roycohen2013/Makerslide/README.md

Most of the code and designes for this device are not in fact mine and are from another developer whos name is mentioned in the code. I merely edited and improved some aspects of the code and hardware to suit my needs better.
