roycohen2013/Makerslide/Makerslide camera slider parts.rtf

1 X MakerSlide 1800mm

4 X Dual Bearing V wheel kits

6ft X Neoprene Belt

2 X Smooth idler wheel kits

14 X precision shim washers

10 X nylon natural spacers

2 X eccentric spacers

15 X 5mm X 0.8mm socket cap screw

15 X 5mm X 0.8mm nylon locking nut

8 X T-slot Nut

1 X Motor/bearing wheel carriage plate

1 X NEMA 17 stepper motor

1X Stepper motor controller
