roycohen2013/Makerslide/Makerslide Designs/Belt clip bottom.sldprt

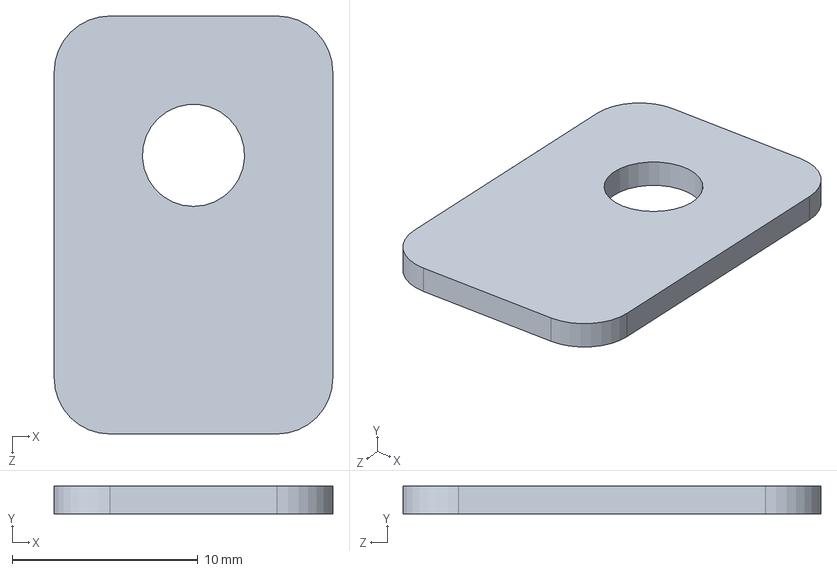
[picture p1: CAD file, 2013-01-02]
Makerslide Designs/Belt clip bottom.sldprt
15.0 x 1.50 x 22.5 mm
