roycohen2013/Makerslide/Makerslide Designs/Sub plate.sldprt

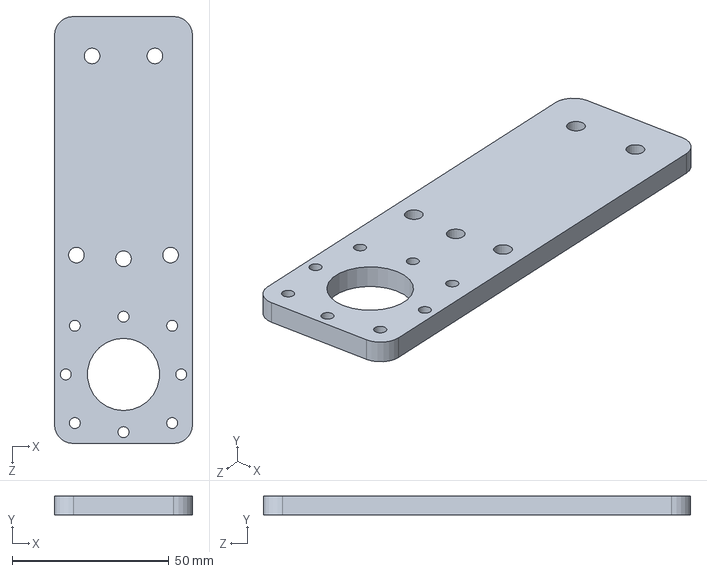
[picture p2: CAD file, 2013-01-02]
Makerslide Designs/Sub plate.sldprt
44.0 x 6.00 x 136.0 mm
