roycohen2013/Makerslide/Makerslide Designs/Rail Clip.sldprt

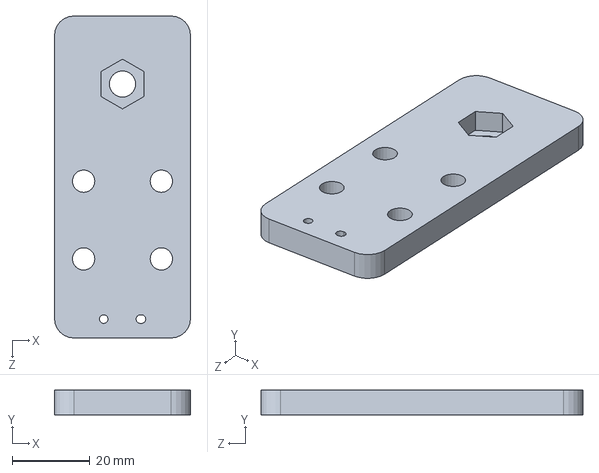
[picture p3: CAD file, 2013-01-02]
Makerslide Designs/Rail Clip.sldprt
35.0 x 6.35 x 82.8 mm
