roycohen2013/Makerslide/(list of files, cad)

Other CAD files:
Makerslide Designs/HN2520MS.sldprt
Makerslide Designs/BHCSM530S.sldprt
Makerslide Designs/SPACER_192_375_312.sldprt
Makerslide Designs/SPACER_192_375_312_1.sldprt
Makerslide Designs/CS_PLATE_1.sldprt
Makerslide Designs/SPACER_192_312_125.sldprt
Makerslide Designs/PHMSM310S.sldprt
Makerslide Designs/HNKK55.sldprt
Makerslide Designs/BEARING_5_16_5.sldprt
Makerslide Designs/BHCSM520S.sldprt
Makerslide Designs/SPACER_192_312_125_1.sldprt
Makerslide Designs/SPACER_192_375_250_1.sldprt
Makerslide Designs/SPACER_192_375_250.sldprt
Makerslide Designs/CS_BELT.sldprt
Makerslide Designs/B10-10001_1.sldprt
Makerslide Designs/FLW10SS.sldprt
Makerslide Designs/B10-10001.sldprt
Makerslide Designs/SHMSM510S.sldprt
Makerslide Designs/BHCSM530S_1.sldprt
Makerslide Designs/HNM5NL_1.sldprt
Makerslide Designs/A_6T16M020DF6005.sldprt
Makerslide Designs/PHMSM310S_1.sldprt
Makerslide Designs/Belt clip top.sldprt
Makerslide Designs/HNM5NL.sldprt
Makerslide Designs/SHMSM512S.sldprt
Makerslide Designs/BEARING_5_16_5_1.sldprt
Makerslide Designs/CS_PLATE.sldprt
Makerslide Designs/Belt clip.sldprt
Makerslide Designs/30048_ASM.sldasm
Makerslide Designs/B17021.sldprt
Makerslide Designs/B17021_1.sldprt
Makerslide Designs/B17022_350.sldprt
Makerslide Designs/B17023.sldprt
Makerslide Designs/B17023_1.sldprt
Makerslide Designs/B17036.STL
Makerslide Designs/B17036.sldprt
Makerslide Designs/B17046.sldprt
Makerslide Designs/B17047.sldprt
Makerslide Designs/B17048.sldprt
Makerslide Designs/B18001-001.sldprt
Makerslide Designs/B18001-001_1.sldprt
Makerslide Designs/B18026.sldprt
Makerslide Designs/B18026_1.sldprt
Makerslide Designs/B30037_ASM.sldasm
Makerslide Designs/B30041_ASM.sldasm
Makerslide Designs/C17045.sldprt
Makerslide Designs/C17045_1.sldprt
Makerslide Designs/C30047_ASM.sldasm
Makerslide Designs/Exports/Belt clip bottom.DXF
Makerslide Designs/Exports/Belt clip top.DXF
Makerslide Designs/Exports/Rail Clip.DXF
Makerslide Designs/Exports/Sub plate.DXF
Makerslide Designs/c30049_rev_1.SLDASM
