roycohen2013/Makerslide/ms ms_slider   Buildlog.net Wiki.html

Buildlog.net Wiki (http://www.buildlog.net/wiki/doku.php)

−Table of Contents

MakerSlide - Simple Camera Slider (http://www.buildlog.net/wiki/doku.php?id=ms:ms_slider&s[]=camera&s[]=slider)

Introduction (http://www.buildlog.net/wiki/doku.php?id=ms:ms_slider&s[]=camera&s[]=slider#introduction)

Part Drawings

Carriage Assembly (http://www.buildlog.net/wiki/doku.php?id=ms:ms_slider&s[]=camera&s[]=slider#carriage_assembly)

Slider Assembly (http://www.buildlog.net/wiki/doku.php?id=ms:ms_slider&s[]=camera&s[]=slider#slider_assembly)

Camera Mounting (http://www.buildlog.net/wiki/doku.php?id=ms:ms_slider&s[]=camera&s[]=slider#camera_mounting)

Slider Setup (http://www.buildlog.net/wiki/doku.php?id=ms:ms_slider&s[]=camera&s[]=slider#slider_setup)

Tripod Mounting (http://www.buildlog.net/wiki/doku.php?id=ms:ms_slider&s[]=camera&s[]=slider#tripod_mounting)

Motor Control (http://www.buildlog.net/wiki/doku.php?id=ms:ms_slider&s[]=camera&s[]=slider#motor_control)

Photos (http://www.buildlog.net/wiki/doku.php?id=ms:ms_slider&s[]=camera&s[]=slider#photos)

MakerSlide - Simple Camera Slider

Introduction

This camera slider is more of a demonstration project than a polished design. The goal was to use as many off the shelf Makerslide parts as possible. The custom parts are the motor and idler pulley support plate, the tripod mounts and the belt clips. These parts are all open source and easy to fabricate. There are no tight tolerances on the parts and could be made with several techniques including hand fabrication.

The Adobe Flash Plugin (http://www.adobe.com/products/flashplayer/) is needed to display this content.

Part Drawings

C30047 Carriage Assembly Drawing - PDF (http://www.buildlog.net/cnc_laser/erp/get_doc.php?docNumber=C30047) - STEP (http://www.buildlog.net/cnc_laser/erp/get_doc.php?docNumber=C30047&type=step)

C30049 Slider Assembly Drawing - PDF (http://www.buildlog.net/cnc_laser/erp/get_doc.php?docNumber=C30049) - STEP (http://www.buildlog.net/cnc_laser/erp/get_doc.php?docNumber=C30049&type=step)

Carriage Assembly

Reference assembly drawing (http://www.buildlog.net/cnc_laser/erp/get_doc.php?docNumber=C30047) when assembling carriage.

Assemble idler pulleys to sub plate.

Place screw in plate

Install spacer on screw.

Press one bearing into idler pulley.

Install idler pulley and onto screw.

Place shim on screw on top of bearing. Important!…this shim is required to prevent binding of the bearings. Many people skip this step.

Press in second bearing.

Install nuts and tighten.

 (http://www.buildlog.net/wiki/lib/exe/detail.php?id=ms%3Ams_slider&media=ms:idler_pulley_assy.jpg)

Assemble sub plate to carriage plate.

Put (3) screws through carriage plate. Not the plate is not symmetrical. Make sure the screw go through the smaller sized holes.

Place spacers over screws.

Place sub plate on screws.

Install nuts and tighten.

 (http://www.buildlog.net/wiki/lib/exe/detail.php?id=ms%3Ams_slider&media=ms:sub_to_carriage.jpg)

Assemble wheels to carriage plate.

Mark each eccentric spacer with a permanent marker on the face that is closest to hole. This will allow you to easily determine the orientation of the hole after it is assembled. It will be easier to see which way you need to rotate the spacer to tighten or loosen the carriage.

 (http://www.buildlog.net/wiki/lib/exe/detail.php?id=ms%3Ams_slider&media=ms:marked_spacer.jpg)

Assemble V wheels. Press aa bearing into each side with a shim washer between them. Try to center the shim washer, but it can usually be adjusted to center later with a thin screwdriver.

Put four screws through carriage plate.

Install (2) nylon spacers

Install (2) eccentric spacers. Orient as shown with hole indicator mark towards the outside. This starts the wheels with the widest separation.

 (http://www.buildlog.net/wiki/lib/exe/detail.php?id=ms%3Ams_slider&media=ms:mounting_wheels.jpg)

Install Motor and Timing Pulley

Install motor using (4) screws. Orient the wiring in the direction you want them facing.

Install pulley. Align center of pulley teeth with center of idler pulleys installed earlier.

 (http://www.buildlog.net/wiki/lib/exe/detail.php?id=ms%3Ams_slider&media=ms:slider_full.jpg)

Slider Assembly

coming soon

Install Thumb Screw caps onto screws. These should be pressed on using a clamp or vise. Do not hammer them on. Do not over press them or they will crack. Just press enough to secure them in place.

Camera Mounting

Most cameras, tripods and heads use a standard #1/4-20 screw. The carriage has several holes that are large enough for that screw. You can also drill out any of the smaller holes or add new ones. Using a small swivel head is handy for shot adjustment.

 (http://www.buildlog.net/wiki/lib/exe/detail.php?id=ms%3Ams_slider&media=ms:cam_mount_01.jpg)

Slider Setup

Use the view and assembly drawing (coming soon) as reference.

Rotate the eccentric spacers to put the wheels as far apart as possible. I usually put a reference dot on the spacer on the side closest to the hole, so it is easy to determine where the hole is of the spacer.

Slide the carriage onto the MakerSlide rail.

Adjust the eccentric spacer to the fit you want. Do not over tighten it or damage can occur to the wheels.

Leave the carriage about 6 inches from one end.

Clamp on end of the belt to the MakerSlide. The toothed side goes towards the MakerSlide. You do not need to tighten the belt too much. The teeth in the belt prevent it from slipping. Excessive tightening could result in cutting the belt over time. Once you determine the right length of the belt, you can leave the clamps in place and lightly tighten the clamps on the belt after you break down the setup for storage or transportation.

Thread the belt around the idler pulleys and timing pulley on the carriage.

Install the other clamp and tension the belt. you only want about 6 lbs of force on the belt. If you pull it really hard, it could bend the motor shaft.

 (http://www.buildlog.net/wiki/lib/exe/detail.php?id=ms%3Ams_slider&media=ms:complete_slider.jpg)

Belt Clamp Detail

 (http://www.buildlog.net/wiki/lib/exe/detail.php?id=ms%3Ams_slider&media=ms:belt_clamp.jpg)

Tripod Mounting

Coming soon.

Motor Control

Simple Controller (http://www.buildlog.net/wiki/doku.php?id=ms:camera_controller)

Photos

 (http://www.buildlog.net/wiki/lib/exe/detail.php?id=ms%3Ams_slider&media=ms:cs_2.jpg)

 (http://www.buildlog.net/wiki/lib/exe/detail.php?id=ms%3Ams_slider&media=ms:cs_1.jpg)

 (http://www.buildlog.net/wiki/lib/exe/detail.php?id=ms%3Ams_slider&media=ms:end_view_01.jpg)

ms/ms_slider.txt · Last modified: 2012/02/10 10:32 by bdring

Recent changes RSS feed (http://www.buildlog.net/wiki/feed.php) Creative Commons License (http://creativecommons.org/licenses/by-nc-sa/2.0/) Valid XHTML 1.0 (http://validator.w3.org/check/referer) Valid CSS (http://jigsaw.w3.org/css-validator/check/referer) Driven by DokuWiki (http://wiki.splitbrain.org/wiki:dokuwiki)
