roycohen2013/Makerslide/(notices)

Notices in the files:
ms ms_slider Buildlog.net Wiki.html:
(http://www.buildlog.net/wiki/feed.php) (http://creativecommons.org/licenses/by-nc-sa/2.0/) (http://validator.w3.org/check/referer) (http://jigsaw.w3.org/css-validator/check/referer) (http://wiki.splitbrain.org/wiki:dokuwiki)
<license rdf:resource="http://creativecommons.org/licenses/by-nc-sa/2.0/" />
<License rdf:about="http://creativecommons.org/licenses/by-nc-sa/2.0/">
